roberttidey/WifiPowerSupply/docs/wifiPS0.jpg

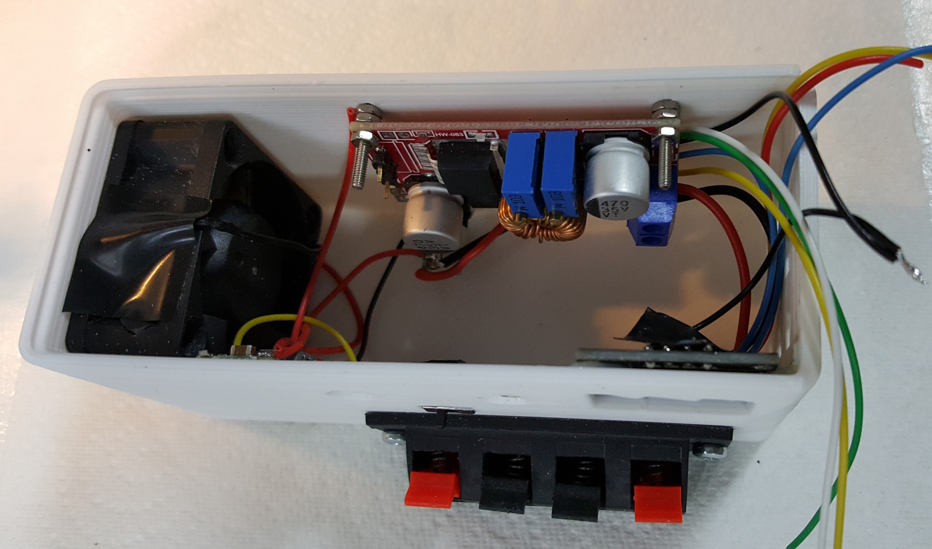
docs/wifiPS0.jpg
