roberttidey/WifiPowerSupply/docs/wifiPS5.jpg

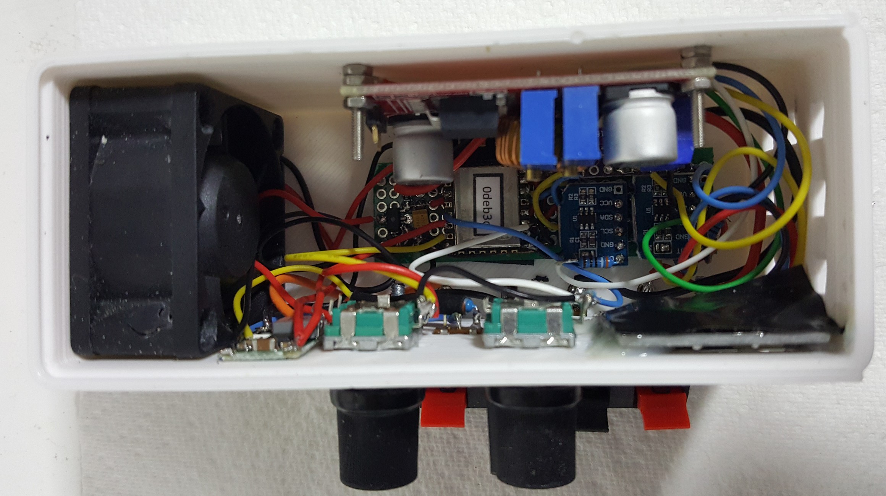
docs/wifiPS5.jpg
