roberttidey/WifiPowerSupply/docs/PowerSupplyLabel.pptx

20mm fan

Wifi
Power
Supply

3.3V

5.0V

Variable

V

I

## Slide 2

10mm fan

3.3V

5.0V

Variable

V

I

Wifi
Power
Supply
