roberttidey/WifiPowerSupply/docs/Schematic_wifiPowerSupply.jpg

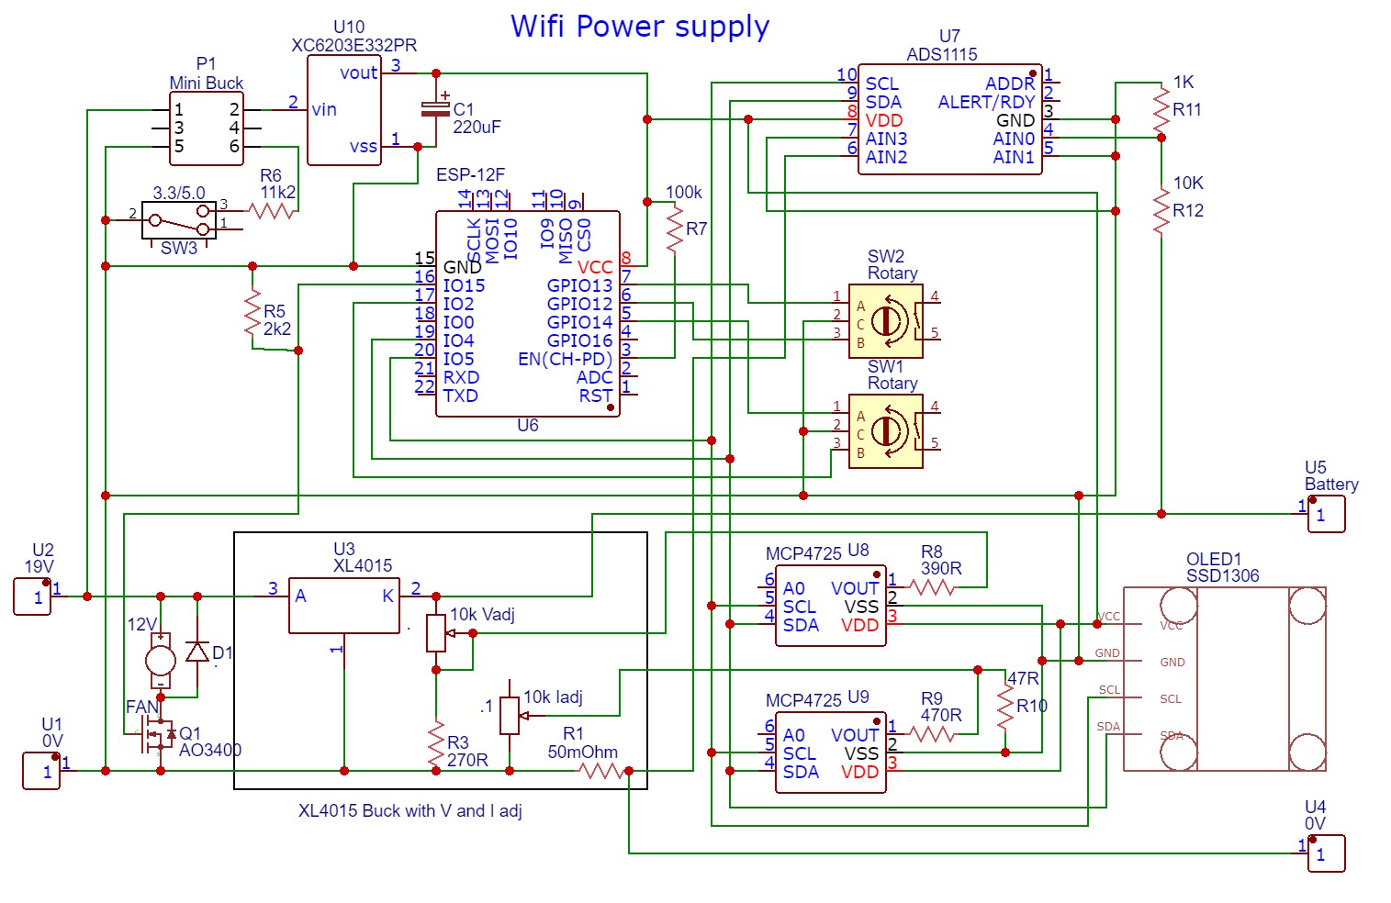
docs/Schematic_wifiPowerSupply.jpg
