roberttidey/WifiPowerSupply/docs/ScreenConfig.jpg

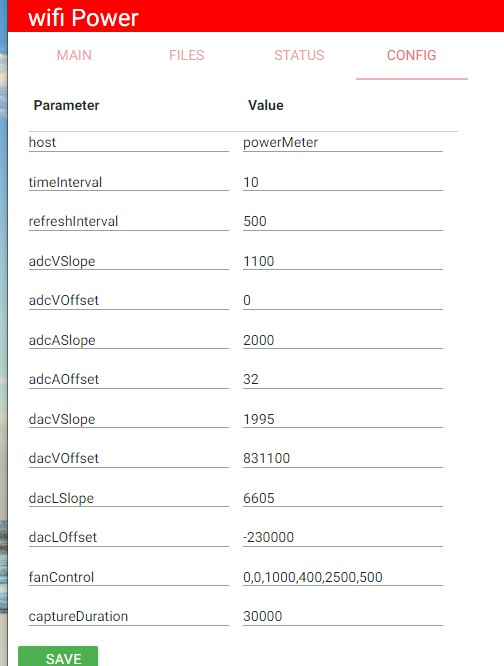
docs/ScreenConfig.jpg
