roberttidey/WifiPowerSupply/docs/ScreenFiles.jpg

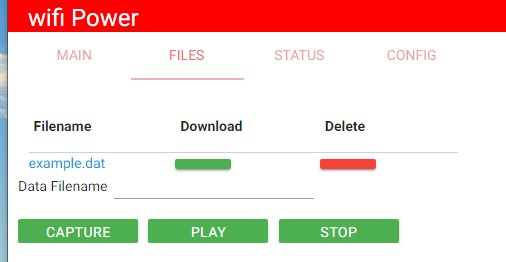
docs/ScreenFiles.jpg
