roberttidey/WifiPowerSupply/docs/ScreenMain.jpg

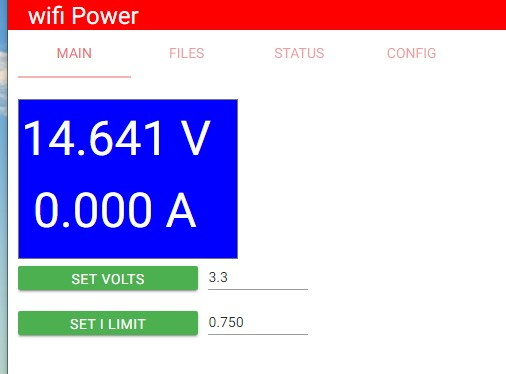
docs/ScreenMain.jpg
