roberttidey/WifiPowerSupply/docs/ScreenStatus.jpg

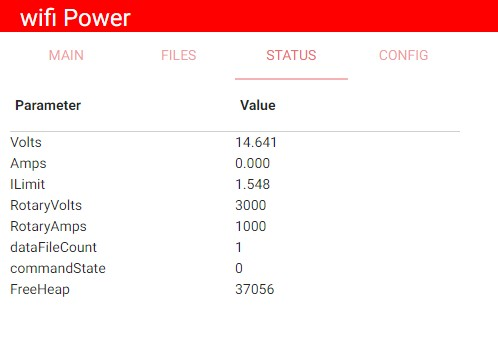
docs/ScreenStatus.jpg
