roberttidey/WifiPowerSupply/docs/WifiPS1.jpg

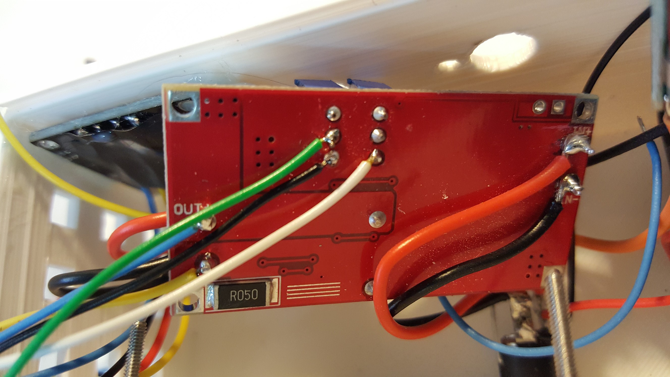
docs/WifiPS1.jpg
