roberttidey/WifiPowerSupply/docs/wifiPS2.jpg

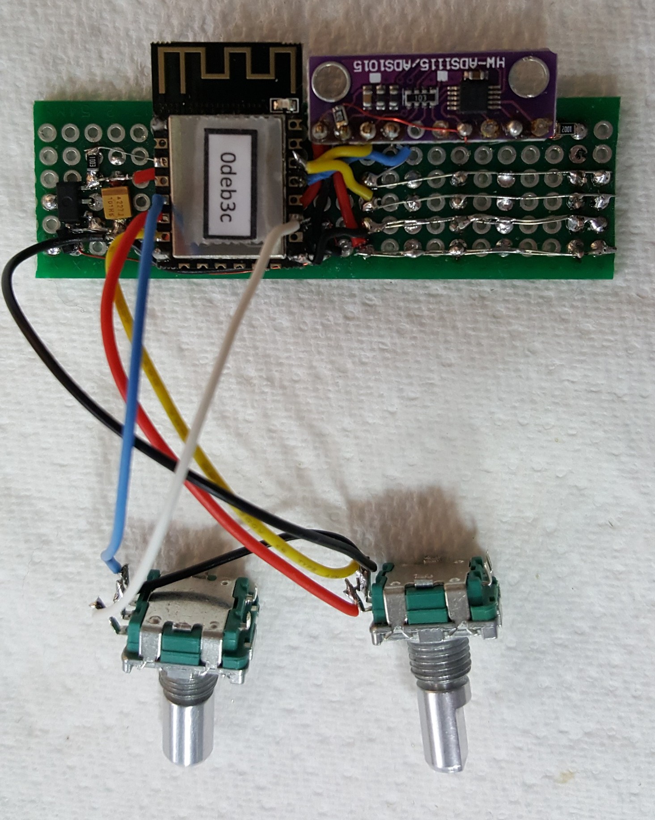
docs/wifiPS2.jpg
