roberttidey/WifiPowerSupply/docs/wifiPS3.jpg

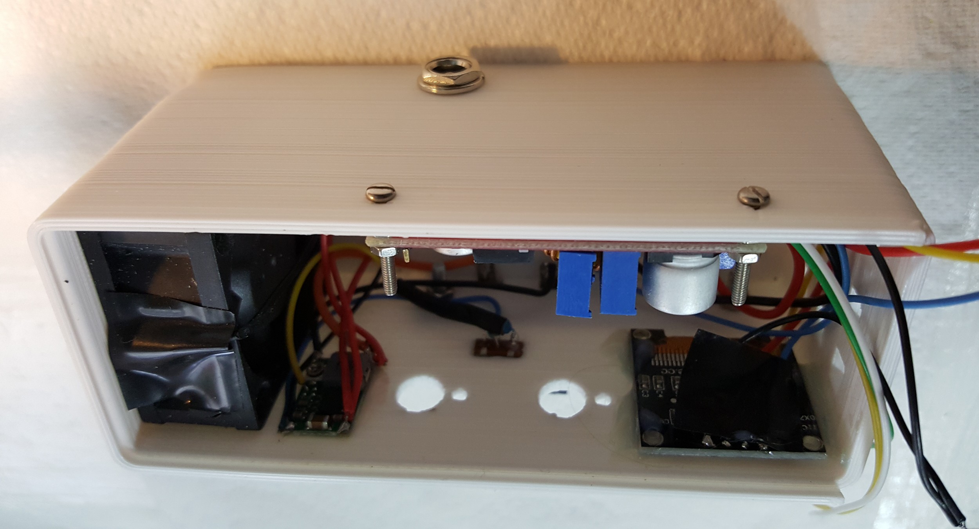
docs/wifiPS3.jpg
