roberttidey/WifiPowerSupply/docs/wifiPS4.jpg

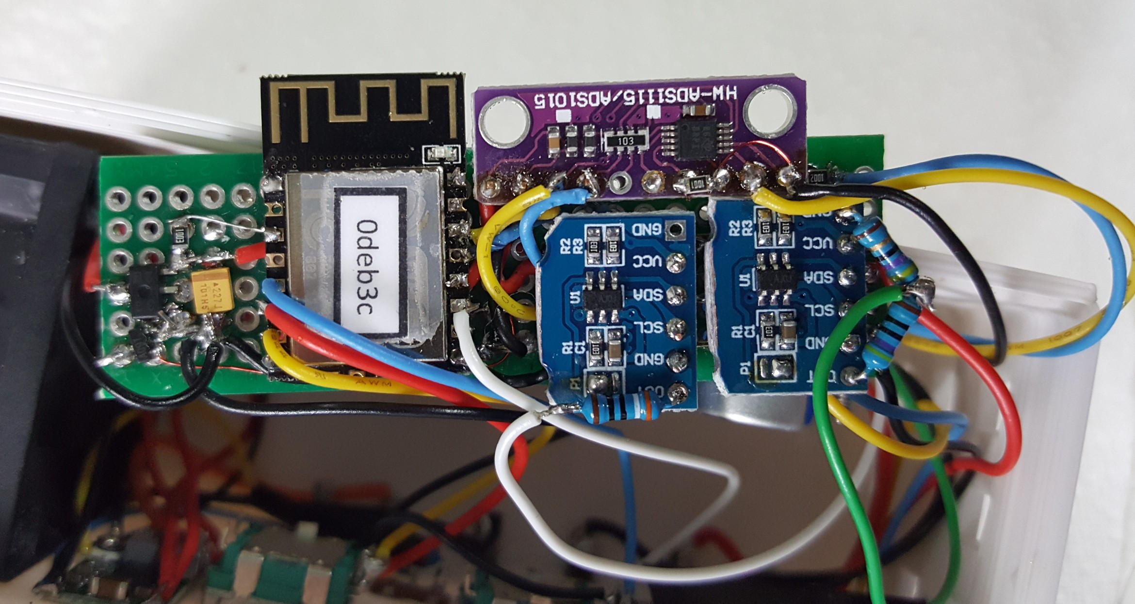
docs/wifiPS4.jpg
