roberttidey/WifiPowerSupply/docs/wifiPSMain.jpg

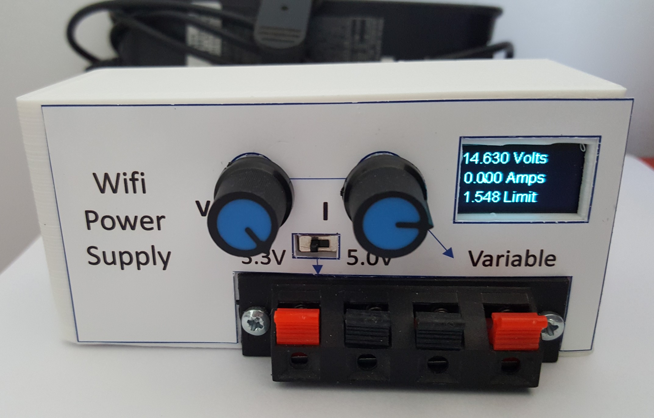
docs/wifiPSMain.jpg
