roberttidey/WifiPowerSupply/data/wifiPowerConfig.txt

#Config file for caliper
# lines are host;timeInterval;displayInterval;adcVSlope;adcVOffset;adcASlope;adcAOffset
# dacVSlope;dacVOffset;dacLSlope;dacLOffset;fanControl (th1:spd1,th2:spd2,th3:sp3);captureDuration
powerMeter
10
500
1100
0
2000
32
#2307
#1250
1970
1140000
6605
-230000
0,0,1000,200,2500,300
30000
