roberttidey/WifiPowerSupply/(commit log)

2021-06-13 Improved dac calibration. Added doc files.
    [wifiPowerConfig.txt]
2021-06-17 Add fan motor catch diode. Add extra doc files
    [Vcal.xlsx]
2021-06-22 prevent ADC not being detected causing reboots.
    [wifiPowerConfig.txt]
2021-07-06 Improve intialisation of play file
    [wifiPowerConfig.txt]
